PabloooC11/Proyecto_DYCDE/BOM_PCB2_PCB2_2026-07-03.xlsx

No. | Quantity | Comment | Designator | Footprint | Value | Manufacturer Part | Manufacturer | Supplier Part | Supplier
1 | 1 | 2.4kHz | BUZZER1 | BUZ-TH_BD12.0-P7.60-D0.6-FD | 2.4kHz | TMB12A05 | 华能 | C96093 | LCSC
2 | 7 | 10uF | C1,C2,C3,C4,C5,C6,C7 | C0805 | 10uF | C0805X106K010T | IHHEC(禾伸堂) | C340314 | LCSC
3 | 2 | 100nF | C8,C9 | C0805 | 100nF | CC0805KRX7R9BB104 | YAGEO(国巨) | C49678 | LCSC
4 | 1 | PRTR5V0U2X | D1 | SOT-143-4_L2.9-W1.3-P1.92-LS2.4-BL |  | PRTR5V0U2X | TECH PUBLIC(台舟) | C2827688 | LCSC
5 | 1 | MBR120LSFT1G | D2 | SOD-123_L2.8-W1.8-LS3.7-RD |  | MBR120LSFT1G | onsemi(安森美) | C891416 | LCSC
6 | 1 | GC9A01_1.28_240x240-Slim | LCD1 | GC9A01_1.28_240x240-Slim
7 | 1 | YLED1206W | LED1 | LED1206-R-RD |  | YLED1206W | YONGYUTAI(永裕泰) | C28310437 | LCSC
8 | 1 | WJ500V-5.08-03P-14-00A | P1_DS18B20 | CONN-TH_3P-P5.00_WJ500V-5.08-3P |  | WJ500V-5.08-03P-14-00A | KANGNEX(康奈克斯电气) | C72334 | LCSC
9 | 4 | MMBT2222ALT1G | Q1,Q2,Q4,Q5 | SOT-23-3_L2.9-W1.3-P1.90-LS2.4-BR |  | MMBT2222ALT1G | onsemi(安森美) | C82460 | LCSC
10 | 1 | DMP2045U-7 | Q3 | SOT-23-3_L2.9-W1.3-P1.90-LS2.4-BR-CW |  | DMP2045U-7 | DIODES(美台) | C459541 | LCSC
11 | 3 | 4.7kΩ | R1,R9,R19 | R0805 | 4.7kΩ | 0805W8F4701T5E | UNI-ROYAL(厚声) | C17673 | LCSC
12 | 3 | 10kΩ | R2,R3,R7 | R0805 | 10kΩ | SCR0805J10K | VO(翔胜) | C5140188 | LCSC
13 | 1 | 80.6kΩ | R4 | R0805 | 80.6kΩ | CR0805F88062G | LIZ(丽智电子) | C101871 | LCSC
14 | 2 | 5.1kΩ | R5,R6 | R0805 | 5.1kΩ | HoAR0805-1/8W-5.1KR-0.1%-TCR25 | Milliohm(毫欧) | C2912598 | LCSC
15 | 1 | 100kΩ | R8 | R0805 | 100kΩ | SCR0805J100K | VO(翔胜) | C3017875 | LCSC
16 | 3 | 1kΩ | R10,R15,R16 | R0805 | 1kΩ | FRC0805F1001TS | FOJAN(富捷) | C2907232 | LCSC
17 | 5 | 220Ω | R11,R12,R13,R14,R18 | R0805 | 220Ω | 0805W8F2200T5E | UNI-ROYAL(厚声) | C17557 | LCSC
18 | 1 | 10kΩ | R17 | RES-ADJ-TH_3296W | 10kΩ | 3296W-1-103 | JIERR(捷而瑞) | C48997937 | LCSC
19 | 2 | PTS820J25MSMTRLFS | SW1,SW2 | KEY-SMD_6P-L3.9-W2.9_PTS820 |  | PTS820J25MSMTRLFS | C&K | C221900 | LCSC
20 | 1 | BME680 | U1 | LGA-8_L3.0-W3.0-P0.80-TR |  | BME680 | Bosch(博世) | C125972 | LCSC
21 | 1 | CH340C | U2 | SOP-16_L10.0-W3.9-P1.27-LS6.0-BL |  | CH340C | WCH(南京沁恒) | C84681 | LCSC
22 | 1 | 2.4GHz | U3 | WIFI-SMD_ESP32-WROVER-E-N8R2 | 2.4GHz | ESP32-WROVER-IE-N16R8 | ESPRESSIF(乐鑫) | C701352 | LCSC
23 | 1 | AP2112K-3.3TRG1 | U6 | SOT-23-5_L2.9-W1.6-P0.95-LS2.8-BR |  | AP2112K-3.3TRG1 | TECH PUBLIC(台舟) | C23380830 | LCSC
24 | 1 | 0805L100WR | U7 | F0805 |  | 0805L100WR | Littelfuse(美国力特) | C80270 | LCSC
25 | 4 | YLED1206R | U8,U9,U10,U11 | LED1206-FD |  | YLED1206R | YONGYUTAI(永裕泰) | C28310439 | LCSC
26 | 1 | MQ-4 | U12 | SENSOR-TH_MQ-4 |  | MQ-4 | Winsen(炜盛) | C99756 | LCSC
27 | 1 | WS2812B-B-V6 | U13_NEOPIXEL | LED-SMD_4P-L5.0-W5.0-TL_WS2812B-B |  | WS2812B-B-V6 | worldsemi | C52941391 | LCSC
28 | 1 | DFRobot Gravity TDS Sensor 1 | U14 | DFRobot Gravity TDS Sensor
29 | 1 | pH sensor module | U15_pHSensor | pH Sensor Module
30 | 1 | U262-161N-4BVC11 | USB1 | USB-3.1-SMD_U262-161N-4BVC11 |  | U262-161N-4BVC11 | XKB Connection(中国星坤) | C319148 | LCSC
